marcuson/pumpkin-demon/docs/img/pumpkin-led-layout.png

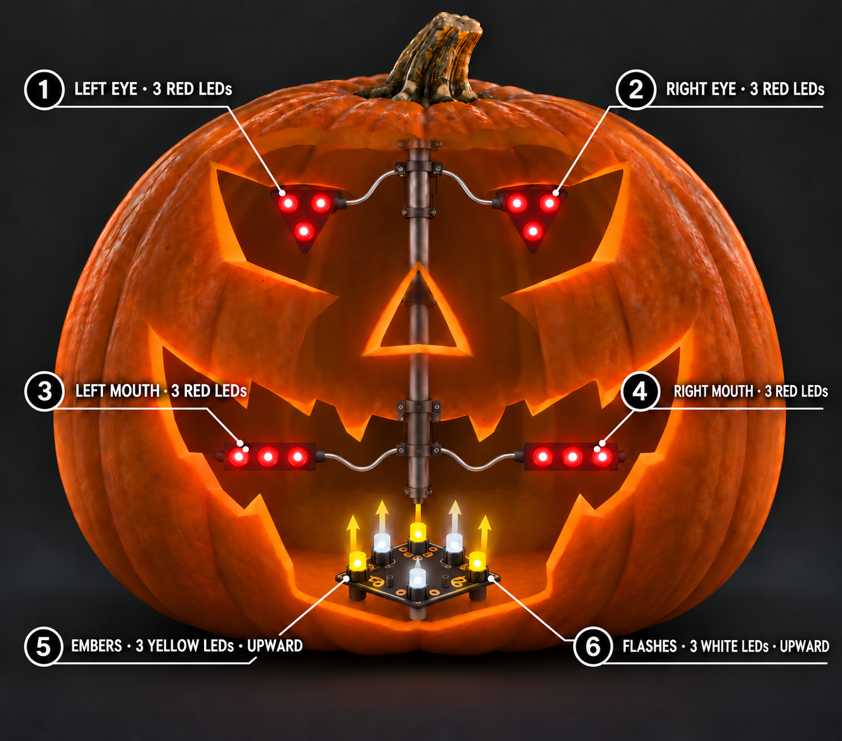
docs/img/pumpkin-led-layout.png
