marcuson/pumpkin-demon/docs/img/pumpkin-demon-schematics.png

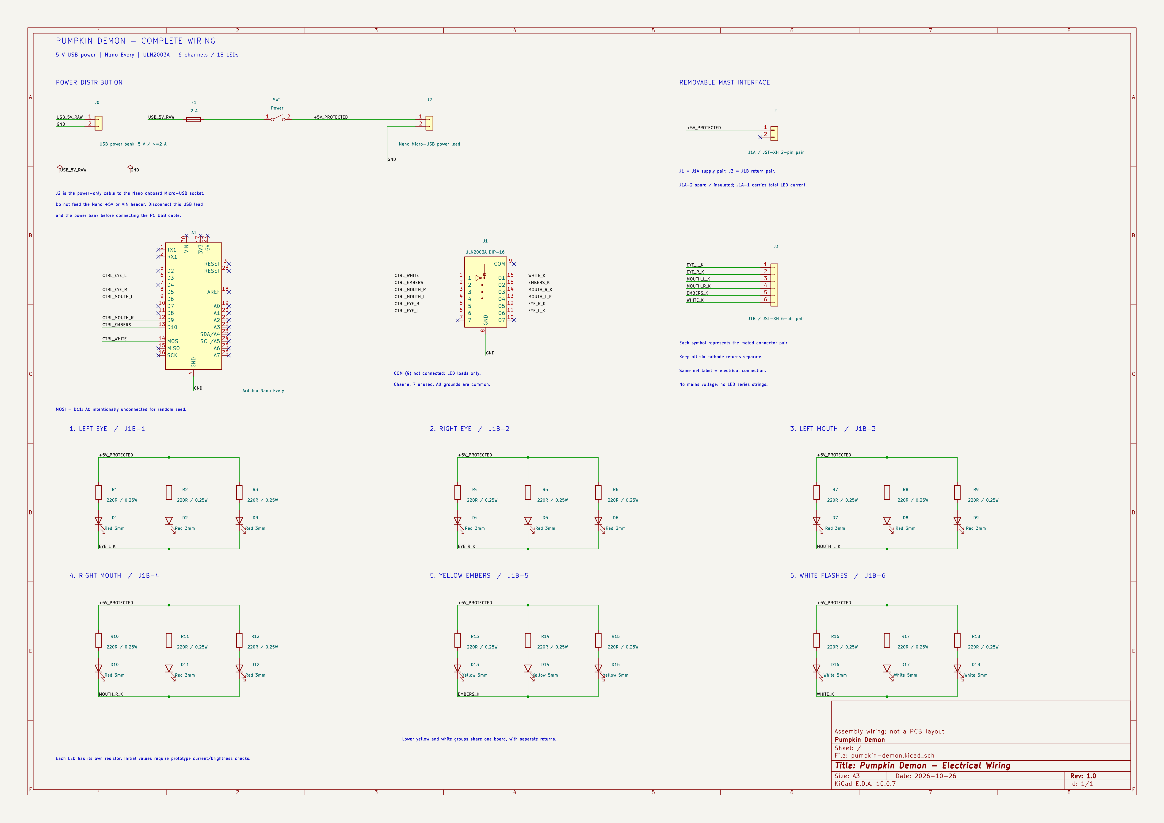
docs/img/pumpkin-demon-schematics.png
