marcuson/pumpkin-demon/docs/electronics/pumpkin-demon.kicad_sch

## KiCad design docs/electronics/pumpkin-demon.kicad_sch (2026-10-26)

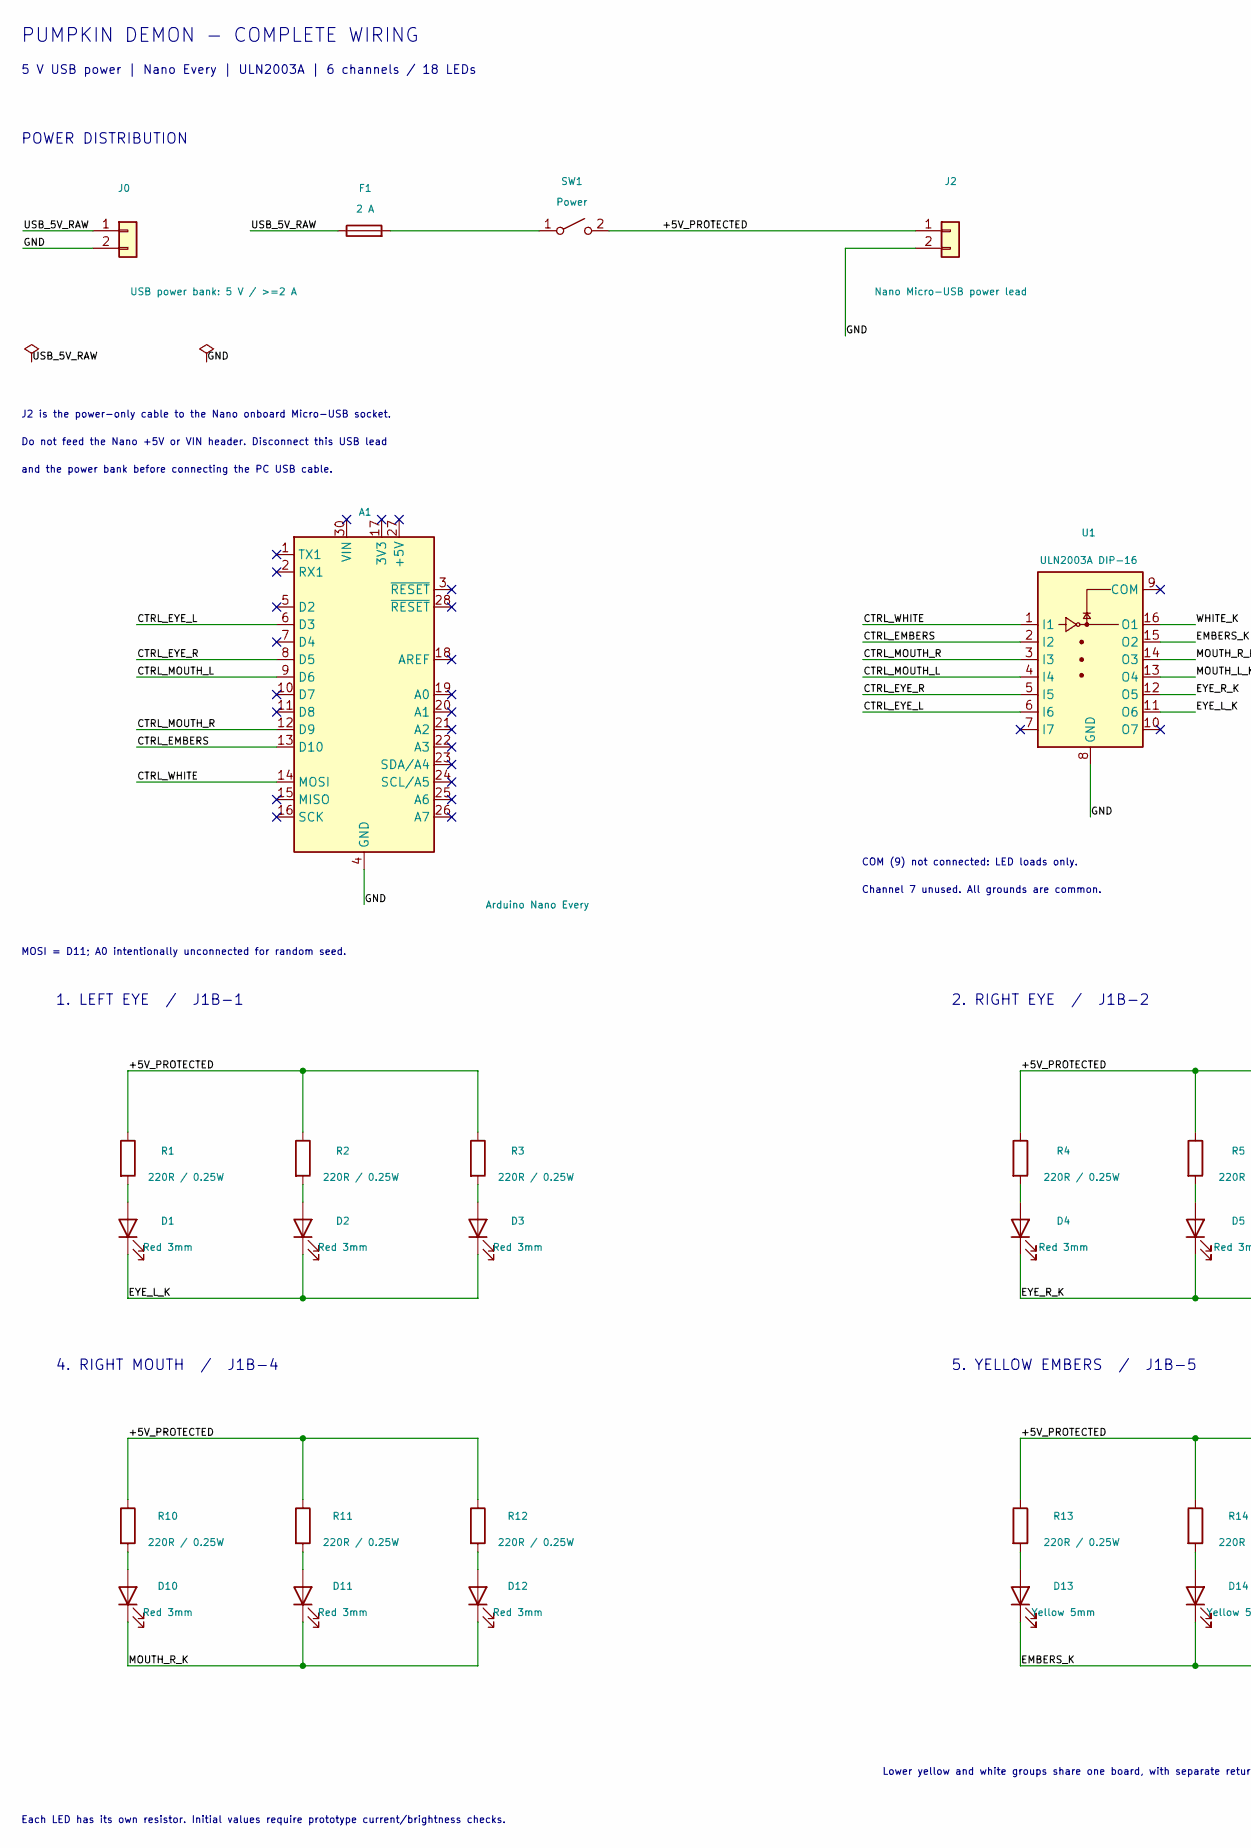
[picture p3: schematic pumpkin-demon.kicad_sch, part in row 1, column 1]

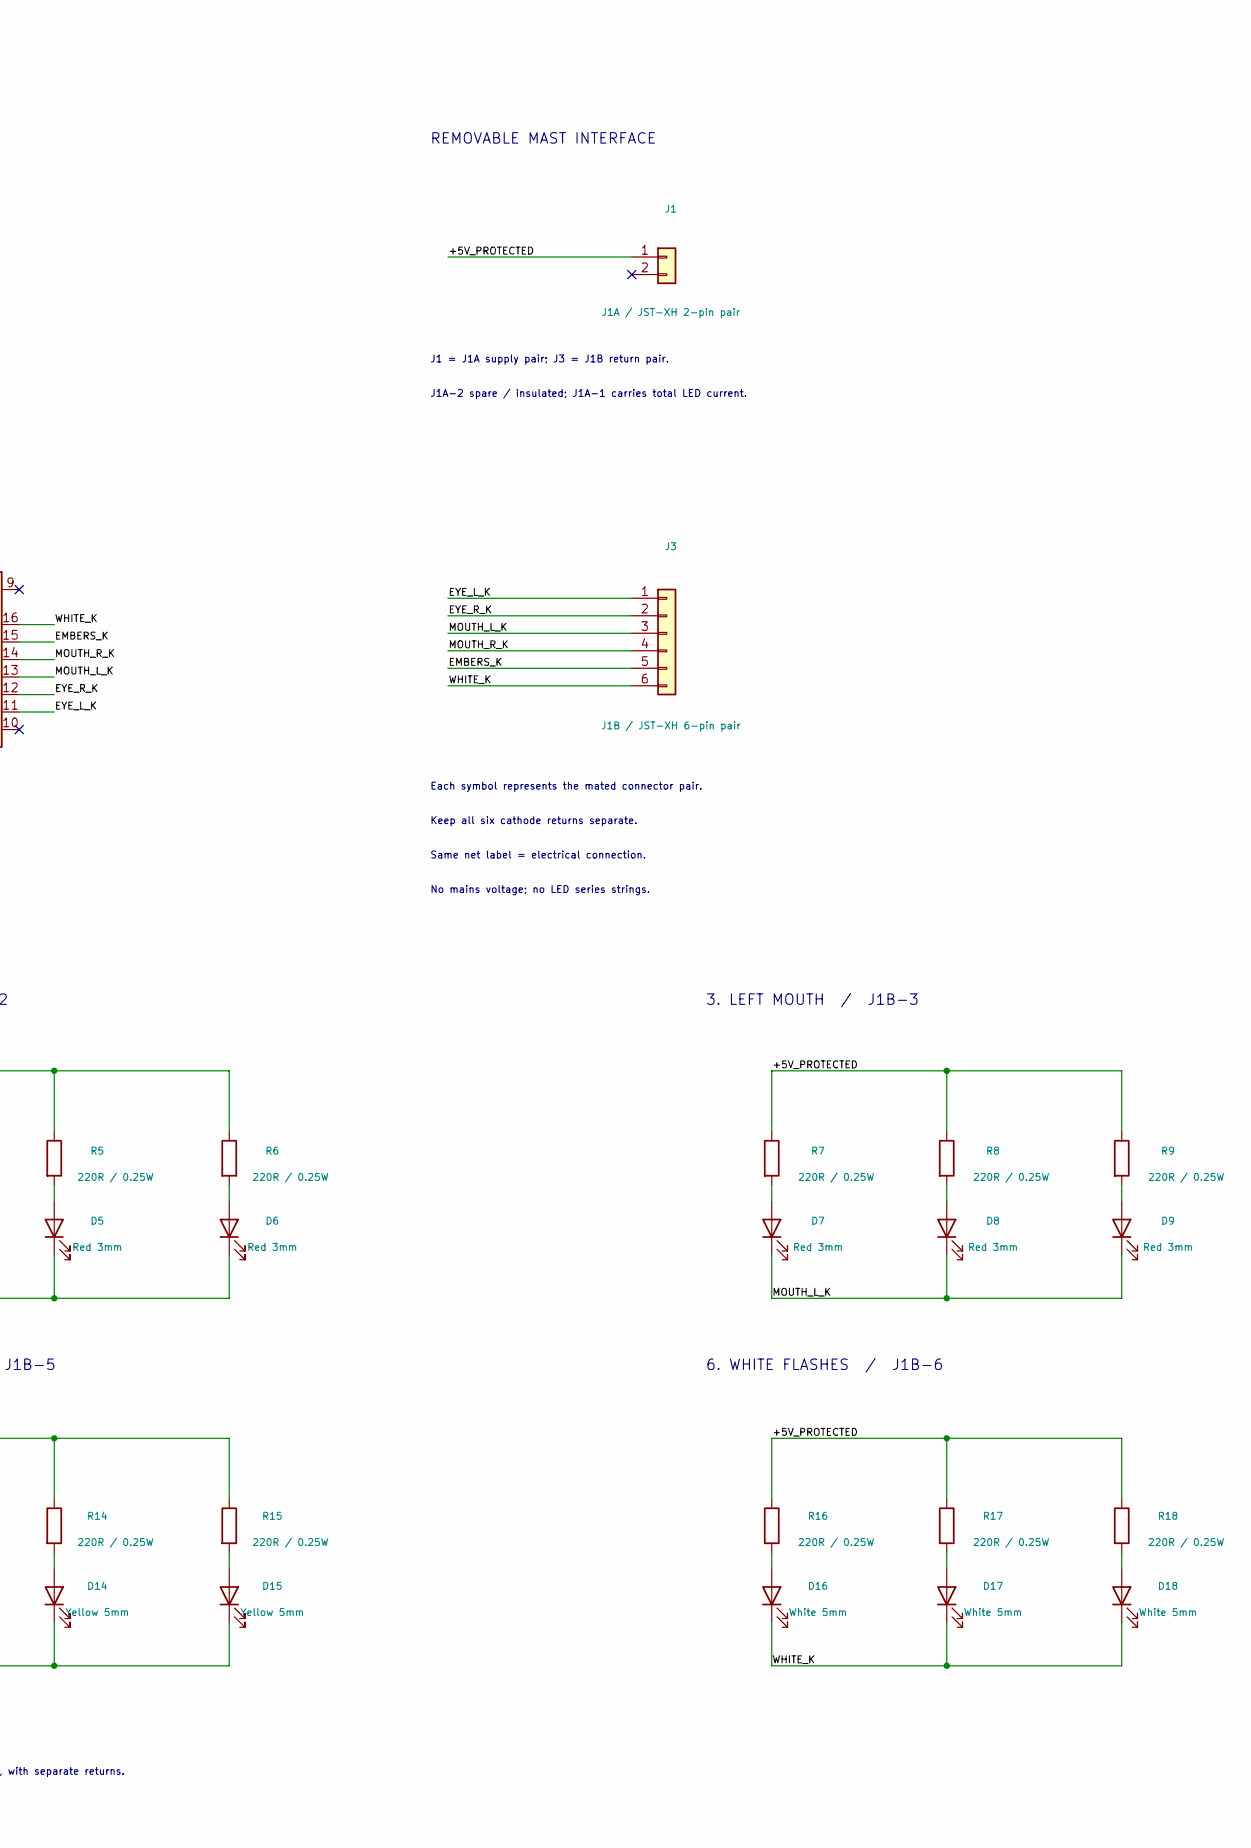
[picture p4: schematic pumpkin-demon.kicad_sch, part in row 1, column 2]

Parts:
A1: Arduino Nano Every
D1, D2, D3, D4, D5, D6, D7, D8, D9, D10, D11, D12: Red 3mm
D13, D14, D15: Yellow 5mm
D16, D17, D18: White 5mm
F1: 2 A
J0: USB power bank: 5 V / >=2 A
J1: J1A / JST-XH 2-pin pair
J2: Nano Micro-USB power lead
J3: J1B / JST-XH 6-pin pair
R1, R2, R3, R4, R5, R6, R7, R8, R9, R10, R11, R12, R13, R14, R15, R16, R17, R18: 220R / 0.25W
SW1: Power
U1: ULN2003A DIP-16

Connections:
+5V_PROTECTED: J1.1, J2.1, R1.1, R2.1, R3.1, R4.1, R5.1, R6.1, R7.1, R8.1, R9.1, R10.1, R11.1, R12.1, R13.1, R14.1, R15.1, R16.1, R17.1, R18.1, SW1.2 (B)
CTRL_EMBERS: A1.13 (D10), U1.2 (I2)
CTRL_EYE_L: A1.6 (D3), U1.6 (I6)
CTRL_EYE_R: A1.8 (D5), U1.5 (I5)
CTRL_MOUTH_L: A1.9 (D6), U1.4 (I4)
CTRL_MOUTH_R: A1.12 (D9), U1.3 (I3)
CTRL_WHITE: A1.14 (MOSI), U1.1 (I1)
EMBERS_K: D13.1 (K), D14.1 (K), D15.1 (K), J3.5, U1.15 (O2)
EYE_L_K: D1.1 (K), D2.1 (K), D3.1 (K), J3.1, U1.11 (O6)
EYE_R_K: D4.1 (K), D5.1 (K), D6.1 (K), J3.2, U1.12 (O5)
GND: A1.4 (GND), A1.29 (GND), J0.2, J2.2, U1.8 (GND)
MOUTH_L_K: D7.1 (K), D8.1 (K), D9.1 (K), J3.3, U1.13 (O4)
MOUTH_R_K: D10.1 (K), D11.1 (K), D12.1 (K), J3.4, U1.14 (O3)
unnamed: D1.2 (A), R1.2
unnamed: D2.2 (A), R2.2
unnamed: D3.2 (A), R3.2
unnamed: D4.2 (A), R4.2
unnamed: D5.2 (A), R5.2
unnamed: D6.2 (A), R6.2
unnamed: D7.2 (A), R7.2
unnamed: D8.2 (A), R8.2
unnamed: D9.2 (A), R9.2
unnamed: D10.2 (A), R10.2
unnamed: D11.2 (A), R11.2
unnamed: D12.2 (A), R12.2
unnamed: D13.2 (A), R13.2
unnamed: D14.2 (A), R14.2
unnamed: D15.2 (A), R15.2
unnamed: D16.2 (A), R16.2
unnamed: D17.2 (A), R17.2
unnamed: D18.2 (A), R18.2
unnamed: F1.2, SW1.1 (A)
USB_5V_RAW: F1.1, J0.1
WHITE_K: D16.1 (K), D17.1 (K), D18.1 (K), J3.6, U1.16 (O1)

Notes on the sheet:
J2 is the power-only cable to the Nano onboard Micro-USB socket.
1. LEFT EYE / J1B-1
Each LED has its own resistor. Initial values require prototype current/brightness checks.
Channel 7 unused. All grounds are common.
Each symbol represents the mated connector pair.
J1A-2 spare / insulated; J1A-1 carries total LED current.
J1 = J1A supply pair; J3 = J1B return pair.
5 V USB power | Nano Every | ULN2003A | 6 channels / 18 LEDs
MOSI = D11; A0 intentionally unconnected for random seed.
Same net label = electrical connection.
Do not feed the Nano +5V or VIN header. Disconnect this USB lead
No mains voltage; no LED series strings.
5. YELLOW EMBERS / J1B-5
6. WHITE FLASHES / J1B-6
PUMPKIN DEMON - COMPLETE WIRING
4. RIGHT MOUTH / J1B-4
and the power bank before connecting the PC USB cable.
3. LEFT MOUTH / J1B-3
POWER DISTRIBUTION
Keep all six cathode returns separate.
Lower yellow and white groups share one board, with separate returns.
REMOVABLE MAST INTERFACE
COM (9) not connected: LED loads only.
2. RIGHT EYE / J1B-2
