marcuson/pumpkin-demon/(commit log)

2026-10-23 feat: wire autonomous lighting and nonblocking serial diagnostics
2026-10-26 feat: Add Kicad project.
    [pumpkin-demon.kicad_sch]
